schinken/dmx2rgb/hw/dmx2rgb.brd

## EAGLE design hw/dmx2rgb.brd (2012-10-02)

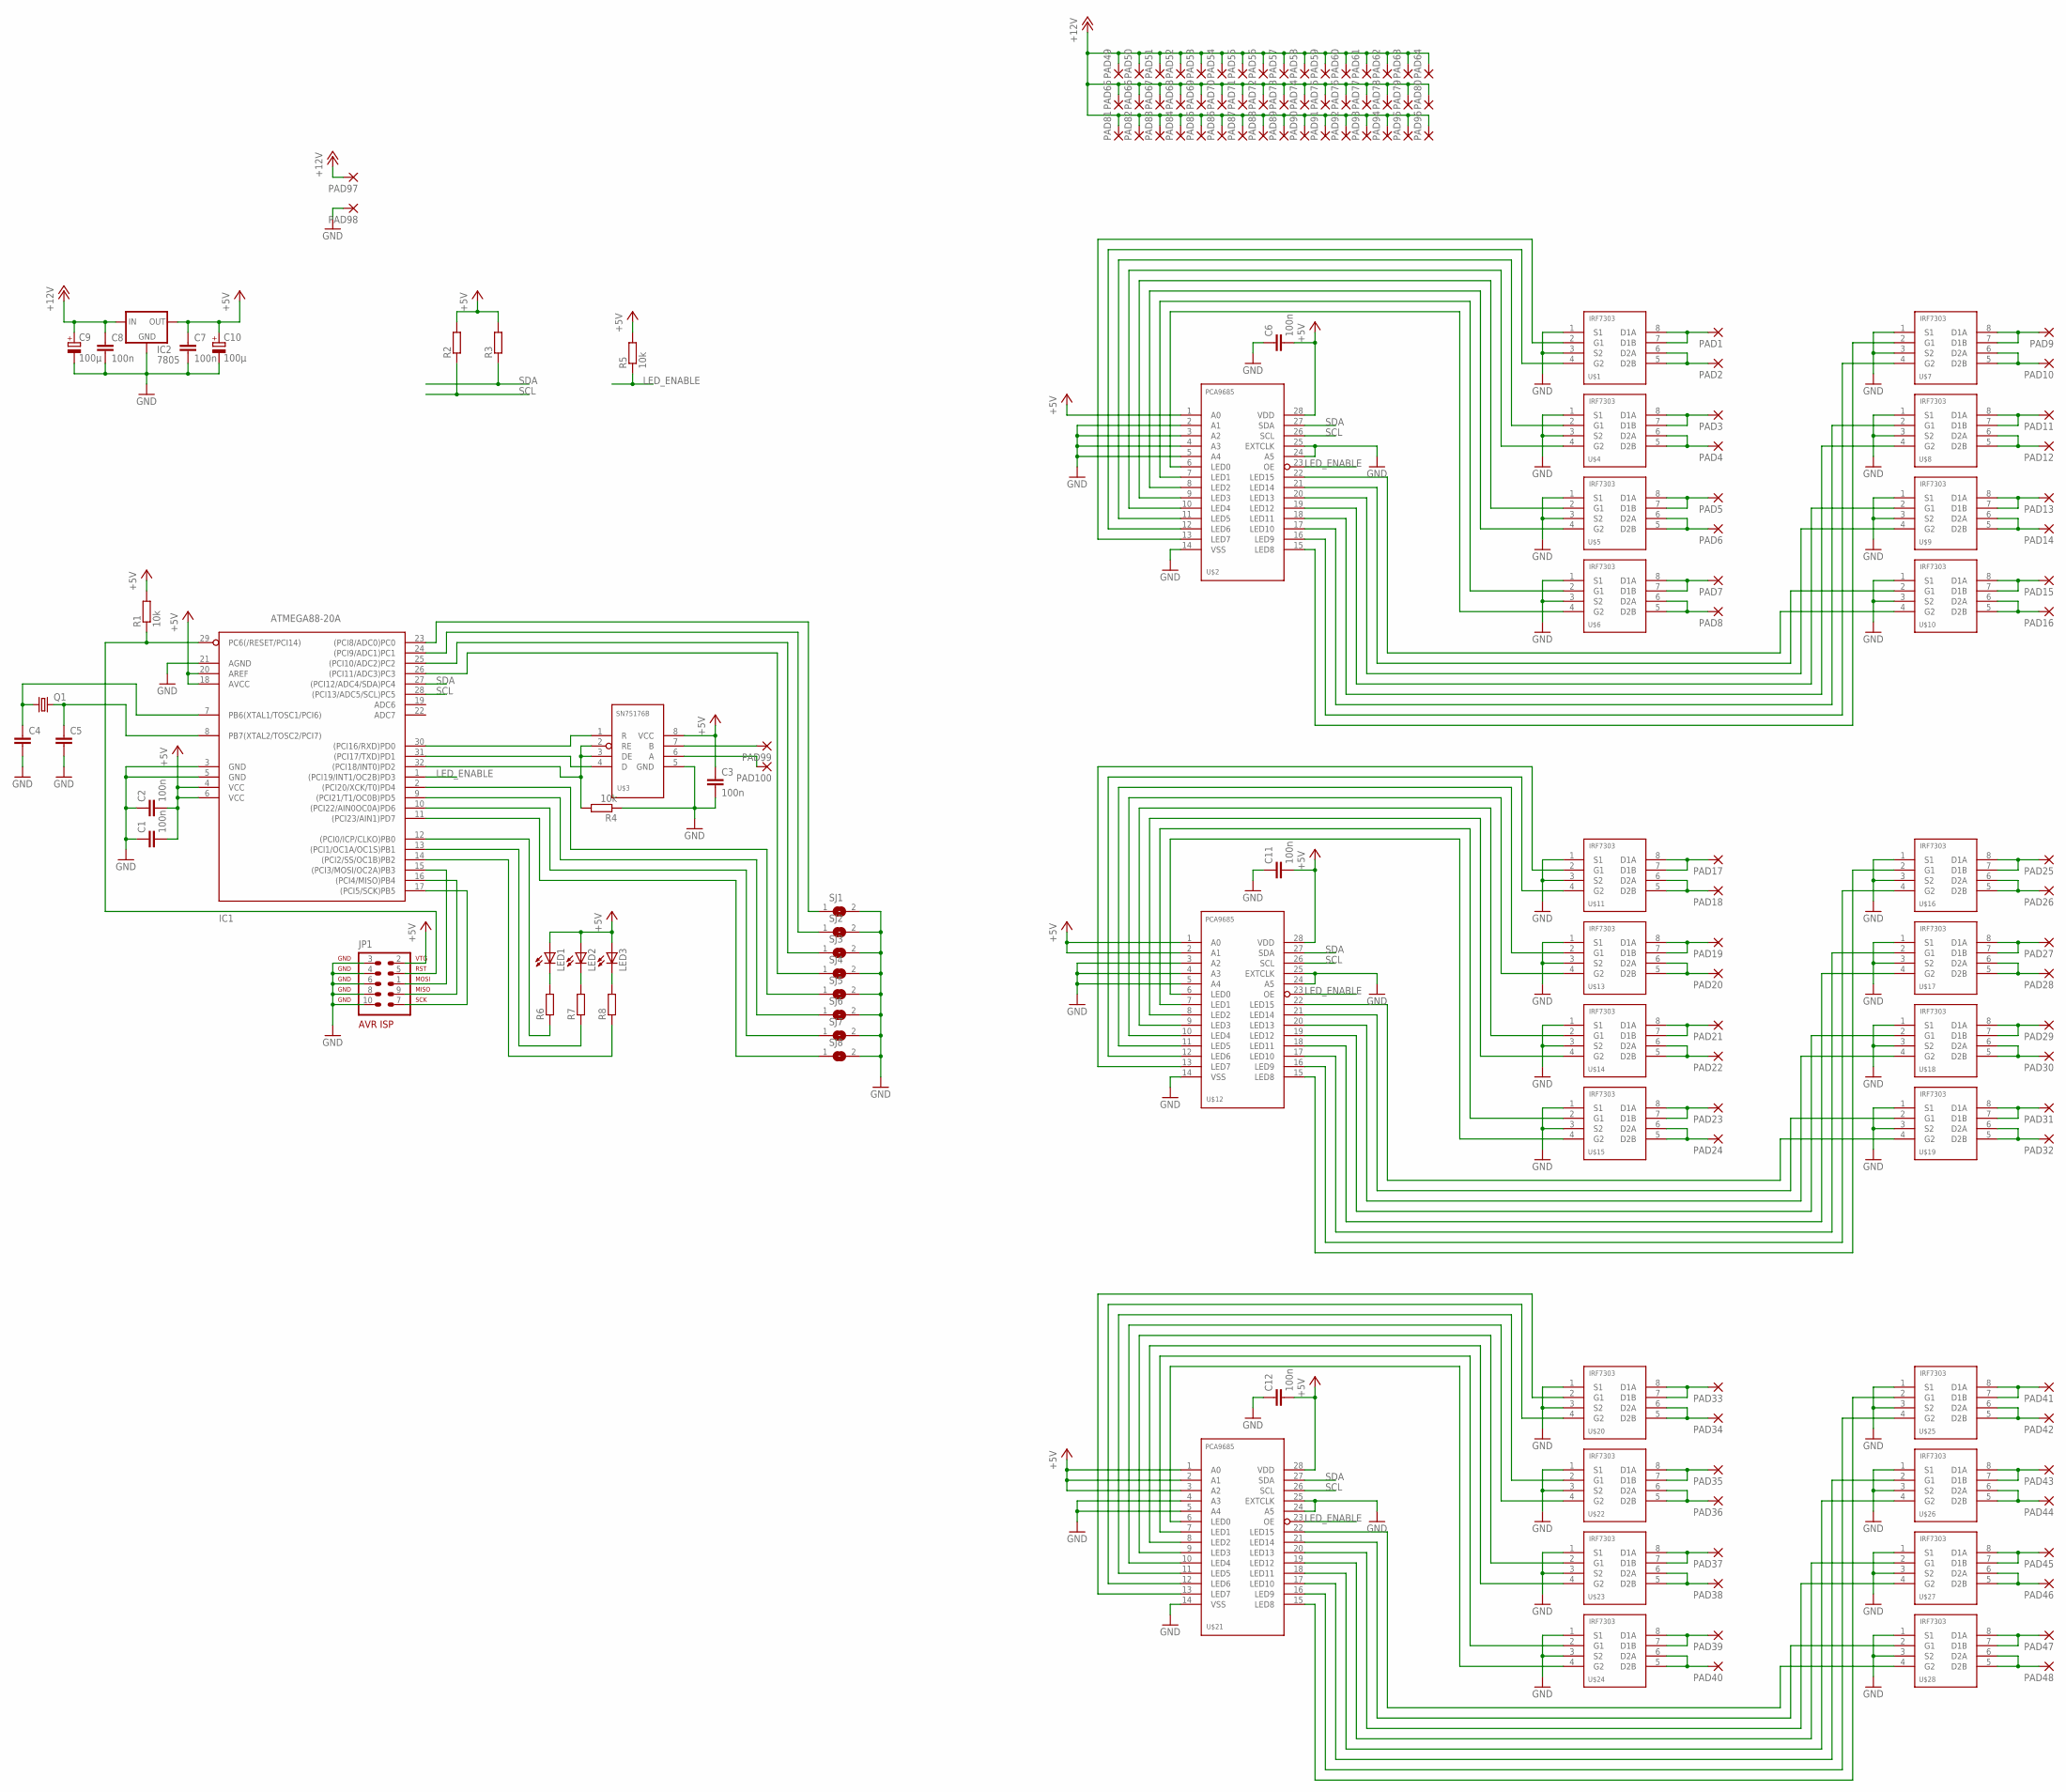
[picture p1: schematic dmx2rgb.sch]

Parts:
C1, C2, C3, C6, C7, C8, C11, C12: 100n; CHIP_0805
C4, C5: C0805; CHIP_0805
C9, C10: 100µ; E2,5-7
IC1: ATMEGA88-20A; TQFP32-08
IC2: 7805; 78LXX
JP1: AVR-ISP-10
LED1, LED2, LED3: LEDCHIPLED_0805; CHIPLED_0805
PAD1, PAD2, PAD3, PAD4, PAD5, PAD6, PAD7, PAD8, PAD9, PAD10, PAD11, PAD12, PAD13, PAD14, PAD15, PAD16, PAD17, PAD18, PAD19, PAD20, PAD21, PAD22, PAD23, PAD24, PAD25, PAD26, PAD27, PAD28, PAD29, PAD30, PAD31, PAD32, PAD33, PAD34, PAD35, PAD36, PAD37, PAD38, PAD39, PAD40, PAD41, PAD42, PAD43, PAD44, PAD45, PAD46, PAD47, PAD48, PAD49, PAD50, PAD51, PAD52, PAD53, PAD54, PAD55, PAD56, PAD57, PAD58, PAD59, PAD60, PAD61, PAD62, PAD63, PAD64, PAD65, PAD66, PAD67, PAD68, PAD69, PAD70, PAD71, PAD72, PAD73, PAD74, PAD75, PAD76, PAD77, PAD78, PAD79, PAD80, PAD81, PAD82, PAD83, PAD84, PAD85, PAD86, PAD87, PAD88, PAD89, PAD90, PAD91, PAD92, PAD93, PAD94, PAD95, PAD96, PAD99, PAD100: SMD_PAD_LONG
PAD97, PAD98: SMD5; SMD2,54-5,08
Q1: CRYSTAL49; HC49/S
R1, R4, R5: 10k; CHIP_0805
R2, R3, R6, R7, R8: R0805; CHIP_0805
SJ1, SJ2, SJ3, SJ4, SJ5, SJ6, SJ7, SJ8: SJ
U$1, U$4, U$5, U$6, U$7, U$8, U$9, U$10, U$11, U$13, U$14, U$15, U$16, U$17, U$18, U$19, U$20, U$22, U$23, U$24, U$25, U$26, U$27, U$28: IRF7303; SO8
U$2, U$12, U$21: PCA9685; TSSOP28
U$3: SN75176B; SO8

Connections:
+5V: C1.2, C2.2, C3.1, C6.2, C7.1, C10.+, C11.2, C12.2, IC1.4 (VCC), IC1.6 (VCC), IC1.18 (AVCC), IC1.20 (AREF), IC2.OUT, JP1.2, LED1.A, LED2.A, LED3.A, R1.2, R2.2, R3.2, R5.2, U$2.1 (A0), U$2.28 (VDD), U$3.8 (VCC), U$12.1 (A0), U$12.2 (A1), U$12.28 (VDD), U$21.1 (A0), U$21.2 (A1), U$21.3 (A2), U$21.28 (VDD)
+12V: C8.1, C9.+, IC2.IN, PAD49.P$1, PAD50.P$1, PAD51.P$1, PAD52.P$1, PAD53.P$1, PAD54.P$1, PAD55.P$1, PAD56.P$1, PAD57.P$1, PAD58.P$1, PAD59.P$1, PAD60.P$1, PAD61.P$1, PAD62.P$1, PAD63.P$1, PAD64.P$1, PAD65.P$1, PAD66.P$1, PAD67.P$1, PAD68.P$1, PAD69.P$1, PAD70.P$1, PAD71.P$1, PAD72.P$1, PAD73.P$1, PAD74.P$1, PAD75.P$1, PAD76.P$1, PAD77.P$1, PAD78.P$1, PAD79.P$1, PAD80.P$1, PAD81.P$1, PAD82.P$1, PAD83.P$1, PAD84.P$1, PAD85.P$1, PAD86.P$1, PAD87.P$1, PAD88.P$1, PAD89.P$1, PAD90.P$1, PAD91.P$1, PAD92.P$1, PAD93.P$1, PAD94.P$1, PAD95.P$1, PAD96.P$1, PAD97.1
GND: C1.1, C2.1, C3.2, C4.2, C5.2, C6.1, C7.2, C8.2, C9.-, C10.-, C11.1, C12.1, IC1.3 (GND), IC1.5 (GND), IC1.21 (AGND), IC2.GND, JP1.3, JP1.4, JP1.6, JP1.8, JP1.10, PAD98.1, R4.1, SJ1.2, SJ2.2, SJ3.2, SJ4.2, SJ5.2, SJ6.2, SJ7.2, SJ8.2, U$1.1 (S1), U$1.3 (S2), U$2.2 (A1), U$2.3 (A2), U$2.4 (A3), U$2.5 (A4), U$2.14 (VSS), U$2.24 (A5), U$2.25 (EXTCLK), U$3.5 (GND), U$4.1 (S1), U$4.3 (S2), U$5.1 (S1), U$5.3 (S2), U$6.1 (S1), U$6.3 (S2), U$7.1 (S1), U$7.3 (S2), U$8.1 (S1), U$8.3 (S2), U$9.1 (S1), U$9.3 (S2), U$10.1 (S1), U$10.3 (S2), U$11.1 (S1), U$11.3 (S2), U$12.3 (A2), U$12.4 (A3), U$12.5 (A4), U$12.14 (VSS), U$12.24 (A5), U$12.25 (EXTCLK), U$13.1 (S1), U$13.3 (S2), U$14.1 (S1), U$14.3 (S2), U$15.1 (S1), U$15.3 (S2), U$16.1 (S1), U$16.3 (S2), U$17.1 (S1), U$17.3 (S2), U$18.1 (S1), U$18.3 (S2), U$19.1 (S1), U$19.3 (S2), U$20.1 (S1), U$20.3 (S2), U$21.4 (A3), U$21.5 (A4), U$21.14 (VSS), U$21.24 (A5), U$21.25 (EXTCLK), U$22.1 (S1), U$22.3 (S2), U$23.1 (S1), U$23.3 (S2), U$24.1 (S1), U$24.3 (S2), U$25.1 (S1), U$25.3 (S2), U$26.1 (S1), U$26.3 (S2), U$27.1 (S1), U$27.3 (S2), U$28.1 (S1), U$28.3 (S2)
LED_ENABLE: IC1.1 ((PCI19/INT1/OC2B)PD3), R5.1, U$2.23 (OE), U$12.23 (OE), U$21.23 (OE)
unnamed: IC1.30 ((PCI16/RXD)PD0), U$3.1 (R)
unnamed: IC1.31 ((PCI17/TXD)PD1), U$3.4 (D)
unnamed: LED3.C, R8.2
unnamed: IC1.32 ((PCI18/INT0)PD2), R4.2, U$3.2 (RE), U$3.3 (DE)
unnamed: PAD1.P$1, U$1.7 (D1B), U$1.8 (D1A)
unnamed: PAD2.P$1, U$1.5 (D2B), U$1.6 (D2A)
unnamed: IC1.29 (PC6(/RESET/PCI14)), JP1.5, R1.1
unnamed: IC1.15 ((PCI3/MOSI/OC2A)PB3), JP1.1
unnamed: IC1.16 ((PCI4/MISO)PB4), JP1.9
unnamed: IC1.17 ((PCI5/SCK)PB5), JP1.7
unnamed: PAD99.P$1, U$3.7 (B)
unnamed: PAD3.P$1, U$4.7 (D1B), U$4.8 (D1A)
unnamed: PAD4.P$1, U$4.5 (D2B), U$4.6 (D2A)
unnamed: LED2.C, R7.2
unnamed: U$2.10 (LED4), U$4.4 (G2)
unnamed: PAD5.P$1, U$5.7 (D1B), U$5.8 (D1A)
unnamed: PAD6.P$1, U$5.5 (D2B), U$5.6 (D2A)
unnamed: U$2.9 (LED3), U$5.2 (G1)
unnamed: U$2.8 (LED2), U$5.4 (G2)
unnamed: PAD7.P$1, U$6.7 (D1B), U$6.8 (D1A)
unnamed: PAD8.P$1, U$6.5 (D2B), U$6.6 (D2A)
unnamed: U$2.7 (LED1), U$6.2 (G1)
unnamed: U$2.6 (LED0), U$6.4 (G2)
unnamed: PAD9.P$1, U$7.7 (D1B), U$7.8 (D1A)
unnamed: PAD10.P$1, U$7.5 (D2B), U$7.6 (D2A)
unnamed: LED1.C, R6.2
unnamed: IC1.12 ((PCI0/ICP/CLKO)PB0), R6.1
unnamed: PAD11.P$1, U$8.7 (D1B), U$8.8 (D1A)
unnamed: PAD12.P$1, U$8.5 (D2B), U$8.6 (D2A)
unnamed: IC1.13 ((PCI1/OC1A/OC1S)PB1), R7.1
unnamed: IC1.14 ((PCI2/SS/OC1B)PB2), R8.1
unnamed: PAD13.P$1, U$9.7 (D1B), U$9.8 (D1A)
unnamed: PAD14.P$1, U$9.5 (D2B), U$9.6 (D2A)
unnamed: IC1.26 ((PCI11/ADC3)PC3), SJ4.1
unnamed: IC1.25 ((PCI10/ADC2)PC2), SJ3.1
unnamed: PAD15.P$1, U$10.7 (D1B), U$10.8 (D1A)
unnamed: PAD16.P$1, U$10.5 (D2B), U$10.6 (D2A)
unnamed: IC1.24 ((PCI9/ADC1)PC1), SJ2.1
unnamed: IC1.23 ((PCI8/ADC0)PC0), SJ1.1
unnamed: C4.1, IC1.7 (PB6(XTAL1/TOSC1/PCI6)), Q1.1
unnamed: C5.1, IC1.8 (PB7(XTAL2/TOSC2/PCI7)), Q1.2
unnamed: IC1.2 ((PCI20/XCK/T0)PD4), SJ5.1
unnamed: IC1.9 ((PCI21/T1/OC0B)PD5), SJ6.1
unnamed: IC1.10 ((PCI22/AIN0OC0A)PD6), SJ7.1
unnamed: IC1.11 ((PCI23/AIN1)PD7), SJ8.1
unnamed: PAD100.P$1, U$3.6 (A)
unnamed: PAD17.P$1, U$11.7 (D1B), U$11.8 (D1A)
unnamed: PAD18.P$1, U$11.5 (D2B), U$11.6 (D2A)
unnamed: U$1.2 (G1), U$2.13 (LED7)
unnamed: U$1.4 (G2), U$2.12 (LED6)
unnamed: U$2.11 (LED5), U$4.2 (G1)
unnamed: U$2.15 (LED8), U$7.2 (G1)
unnamed: U$2.16 (LED9), U$7.4 (G2)
unnamed: U$2.17 (LED10), U$8.2 (G1)
unnamed: U$2.18 (LED11), U$8.4 (G2)
unnamed: U$2.19 (LED12), U$9.2 (G1)
unnamed: U$2.20 (LED13), U$9.4 (G2)
unnamed: U$2.21 (LED14), U$10.2 (G1)
unnamed: U$2.22 (LED15), U$10.4 (G2)
unnamed: PAD19.P$1, U$13.7 (D1B), U$13.8 (D1A)
unnamed: PAD20.P$1, U$13.5 (D2B), U$13.6 (D2A)
unnamed: U$12.10 (LED4), U$13.4 (G2)
unnamed: PAD21.P$1, U$14.7 (D1B), U$14.8 (D1A)
unnamed: PAD22.P$1, U$14.5 (D2B), U$14.6 (D2A)
unnamed: U$12.9 (LED3), U$14.2 (G1)
unnamed: U$12.8 (LED2), U$14.4 (G2)
unnamed: PAD23.P$1, U$15.7 (D1B), U$15.8 (D1A)
unnamed: PAD24.P$1, U$15.5 (D2B), U$15.6 (D2A)
unnamed: U$12.7 (LED1), U$15.2 (G1)
unnamed: U$12.6 (LED0), U$15.4 (G2)
unnamed: PAD25.P$1, U$16.7 (D1B), U$16.8 (D1A)
unnamed: PAD26.P$1, U$16.5 (D2B), U$16.6 (D2A)
unnamed: PAD27.P$1, U$17.7 (D1B), U$17.8 (D1A)
unnamed: PAD28.P$1, U$17.5 (D2B), U$17.6 (D2A)
unnamed: PAD29.P$1, U$18.7 (D1B), U$18.8 (D1A)
unnamed: PAD30.P$1, U$18.5 (D2B), U$18.6 (D2A)
unnamed: PAD31.P$1, U$19.7 (D1B), U$19.8 (D1A)
unnamed: PAD32.P$1, U$19.5 (D2B), U$19.6 (D2A)
unnamed: U$11.2 (G1), U$12.13 (LED7)
unnamed: U$11.4 (G2), U$12.12 (LED6)
unnamed: U$12.11 (LED5), U$13.2 (G1)
unnamed: U$12.15 (LED8), U$16.2 (G1)
unnamed: U$12.16 (LED9), U$16.4 (G2)
unnamed: U$12.17 (LED10), U$17.2 (G1)
unnamed: U$12.18 (LED11), U$17.4 (G2)
unnamed: U$12.19 (LED12), U$18.2 (G1)
unnamed: U$12.20 (LED13), U$18.4 (G2)
unnamed: U$12.21 (LED14), U$19.2 (G1)
unnamed: U$12.22 (LED15), U$19.4 (G2)
unnamed: PAD33.P$1, U$20.7 (D1B), U$20.8 (D1A)
unnamed: PAD34.P$1, U$20.5 (D2B), U$20.6 (D2A)
unnamed: PAD35.P$1, U$22.7 (D1B), U$22.8 (D1A)
unnamed: PAD36.P$1, U$22.5 (D2B), U$22.6 (D2A)
unnamed: U$21.10 (LED4), U$22.4 (G2)
unnamed: PAD37.P$1, U$23.7 (D1B), U$23.8 (D1A)
unnamed: PAD38.P$1, U$23.5 (D2B), U$23.6 (D2A)
unnamed: U$21.9 (LED3), U$23.2 (G1)
unnamed: U$21.8 (LED2), U$23.4 (G2)
unnamed: PAD39.P$1, U$24.7 (D1B), U$24.8 (D1A)
unnamed: PAD40.P$1, U$24.5 (D2B), U$24.6 (D2A)
unnamed: U$21.7 (LED1), U$24.2 (G1)
unnamed: U$21.6 (LED0), U$24.4 (G2)
unnamed: PAD41.P$1, U$25.7 (D1B), U$25.8 (D1A)
unnamed: PAD42.P$1, U$25.5 (D2B), U$25.6 (D2A)
unnamed: PAD43.P$1, U$26.7 (D1B), U$26.8 (D1A)
unnamed: PAD44.P$1, U$26.5 (D2B), U$26.6 (D2A)
unnamed: PAD45.P$1, U$27.7 (D1B), U$27.8 (D1A)
unnamed: PAD46.P$1, U$27.5 (D2B), U$27.6 (D2A)
unnamed: PAD47.P$1, U$28.7 (D1B), U$28.8 (D1A)
unnamed: PAD48.P$1, U$28.5 (D2B), U$28.6 (D2A)
unnamed: U$20.2 (G1), U$21.13 (LED7)
unnamed: U$20.4 (G2), U$21.12 (LED6)
unnamed: U$21.11 (LED5), U$22.2 (G1)
unnamed: U$21.15 (LED8), U$25.2 (G1)
unnamed: U$21.16 (LED9), U$25.4 (G2)
unnamed: U$21.17 (LED10), U$26.2 (G1)
unnamed: U$21.18 (LED11), U$26.4 (G2)
unnamed: U$21.19 (LED12), U$27.2 (G1)
unnamed: U$21.20 (LED13), U$27.4 (G2)
unnamed: U$21.21 (LED14), U$28.2 (G1)
unnamed: U$21.22 (LED15), U$28.4 (G2)
SCL: IC1.28 ((PCI13/ADC5/SCL)PC5), R2.1, U$2.26 (SCL), U$12.26 (SCL), U$21.26 (SCL)
SDA: IC1.27 ((PCI12/ADC4/SDA)PC4), R3.1, U$2.27 (SDA), U$12.27 (SDA), U$21.27 (SDA)

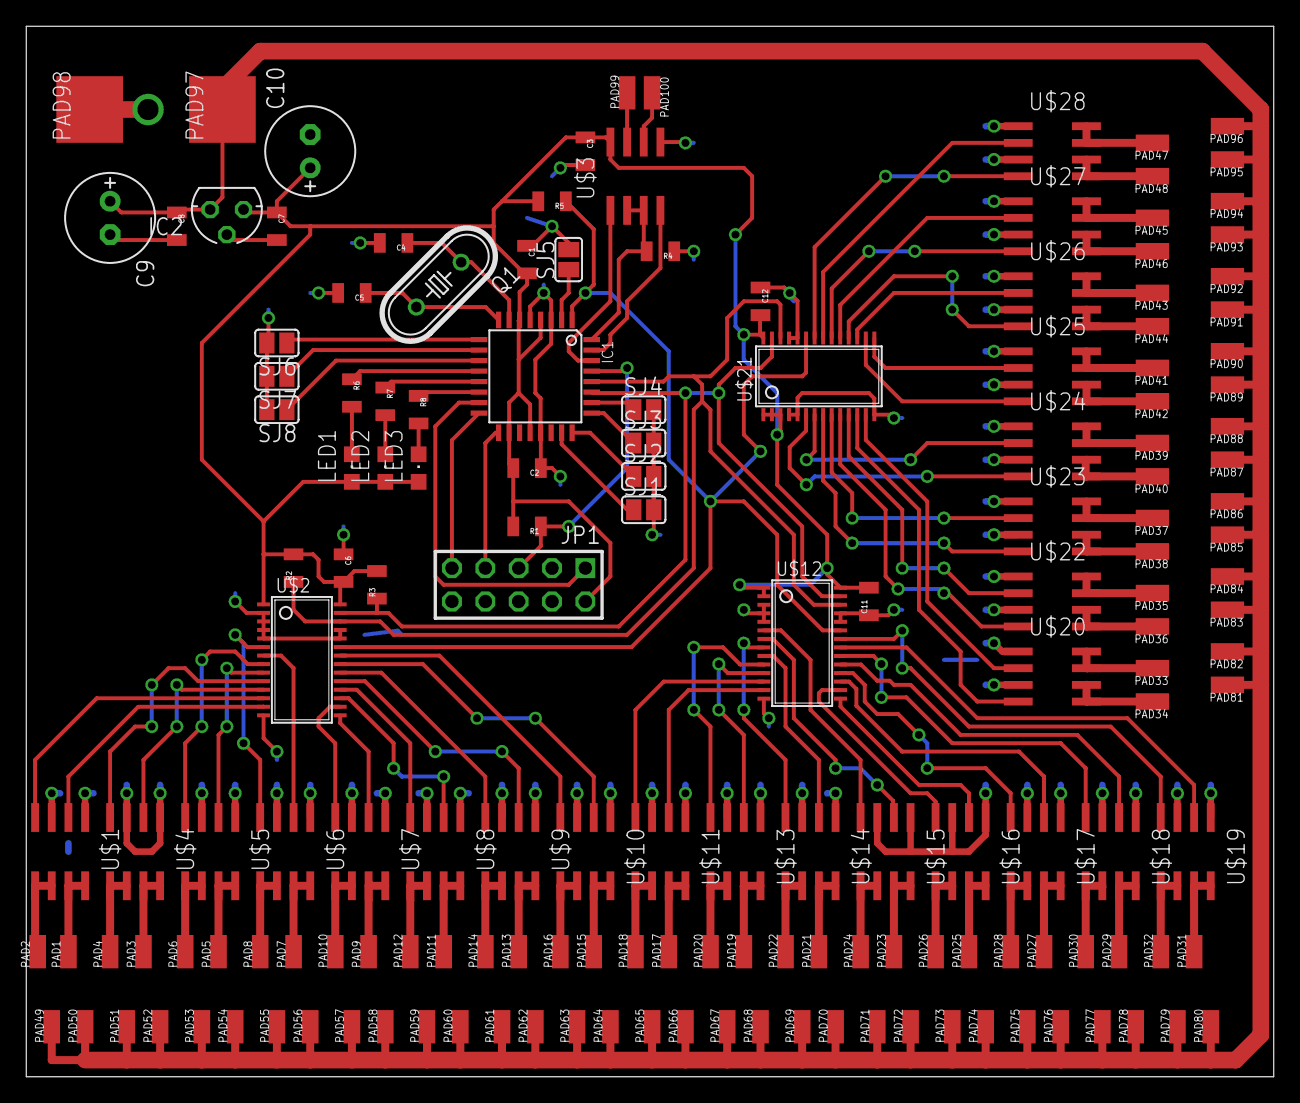
[picture p2: board dmx2rgb.brd from above]

Board: 2 copper layers, 95.0 x 80.0 mm, 163 parts (0 on the bottom side), 127 nets.
