schinken/dmx2rgb/(commit log)

2012-08-23 added pwm driver and fet devices added some other devices as well typo fix
    [dmx2rgb.sch]
2012-08-27 basic schematics added new parts to library
    [dmx2rgb.sch]
2012-08-27 added some pull ups added layout file
    [dmx2rgb.sch]
2012-08-27 adressing through solder jumpers
    [dmx2rgb.brd, dmx2rgb.sch]
2012-09-11 all parts added some parts placed
    [dmx2rgb.brd, dmx2rgb.sch]
2012-09-13 pcb finished prepared for 0.3mm milling
    [dmx2rgb.brd, dmx2rgb.sch]
2012-09-14 removed drilling below mcu
    [dmx2rgb.brd]
2012-10-02 optimized and doublesided
    [dmx2rgb.brd]
2012-10-11 added pca9685 prototype
2012-10-11 read correct amount of data
    [pca9685.c]
2012-10-11 added mapping, using dmx values for pwm
2012-10-11 Added i2c and pca c file
2012-10-11 Added i2c library
2012-10-11 enabled other pwm chips
2012-10-11 set correct channel num
    [dmx2rgb.h]
2012-10-11 set i2c freq to 400khz
2012-10-12 Added led toggle
2012-11-06 pwm frequency added, disaligns the 3 PCA chip clock, prevents flickering
    [dmx2rgb.c, pca9685.c]
2015-08-29 Add fuses
